yazandweiri9380/wireless-nerve-stimulator/README.md

# wireless-nerve-stimulator
Hardware designs, firmware, and supporting software for a compact wireless peripheral nerve stimulator with onboard inverse mapping.
