yazandweiri9380/wireless-nerve-stimulator/Electronics/PCB Design Files/SlikScreen.pdf

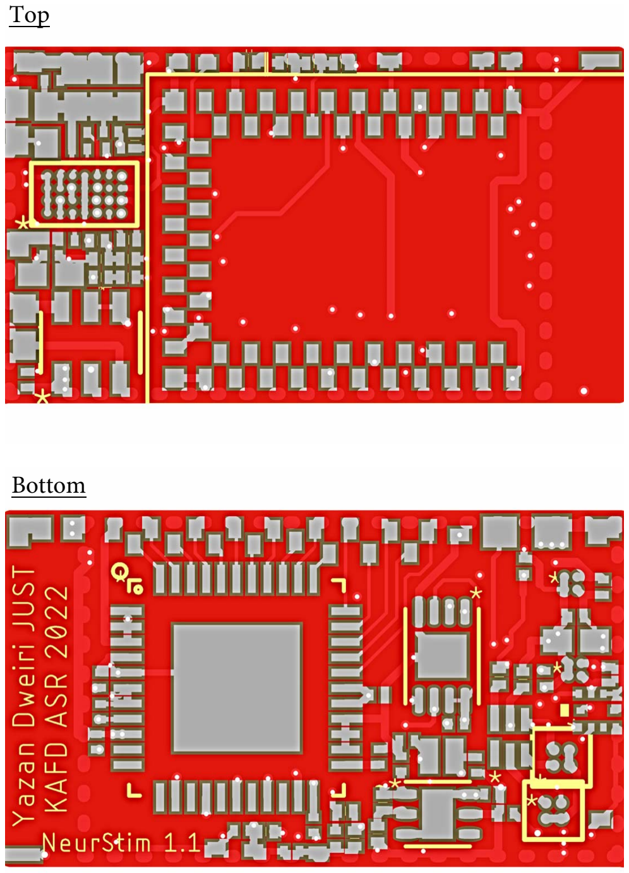
[picture p1: page 1]

Top

Bottom

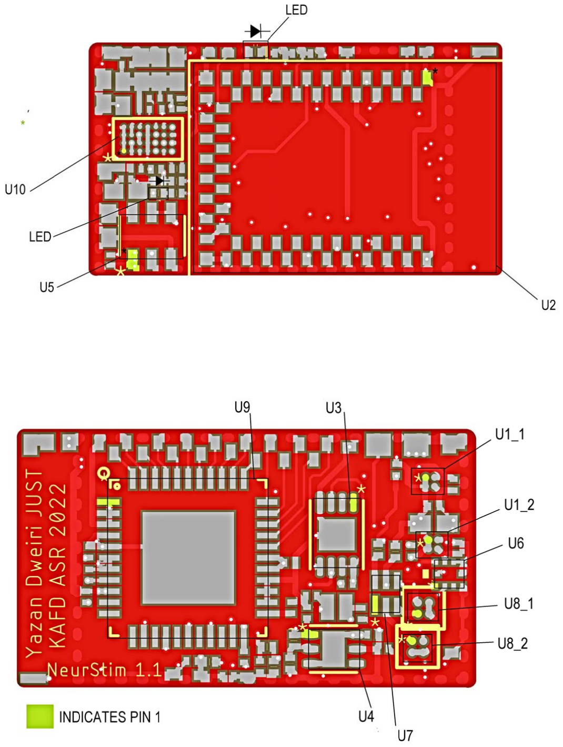
[picture p2: page 2]
