yazandweiri9380/wireless-nerve-stimulator/Electronics/PCB Design Files/Bottom2.png

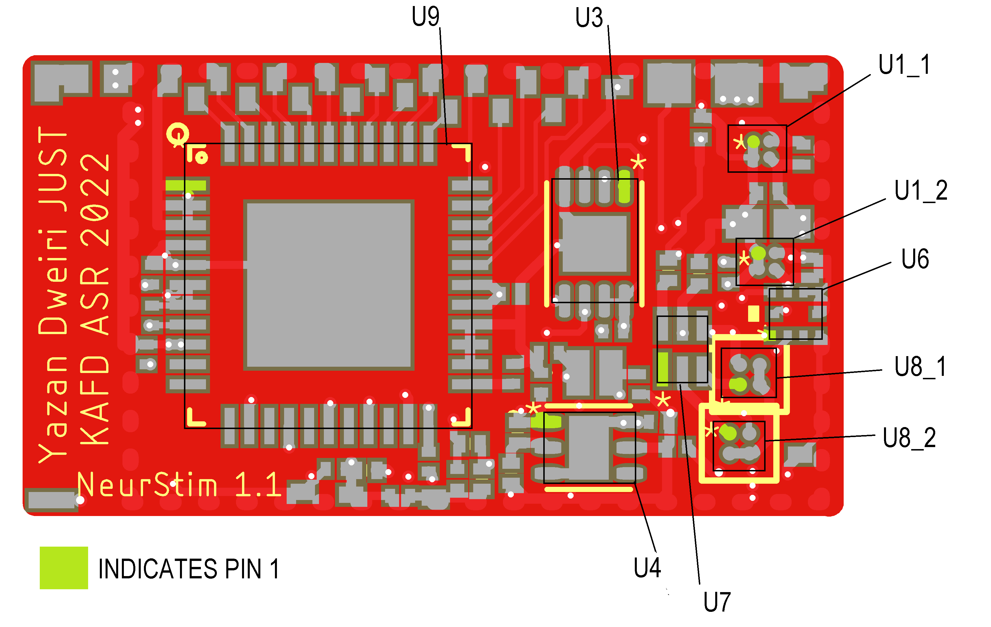
Electronics/PCB Design Files/Bottom2.png
