yazandweiri9380/wireless-nerve-stimulator/Electronics/PCB Design Files/Bottom.png

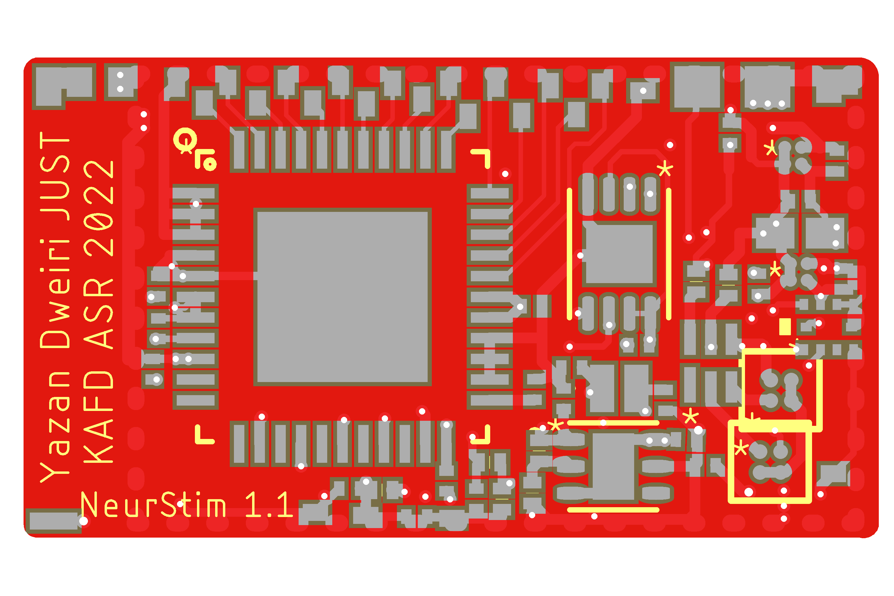
Electronics/PCB Design Files/Bottom.png
