yazandweiri9380/wireless-nerve-stimulator/Electronics/PCB Design Files/Top2.png

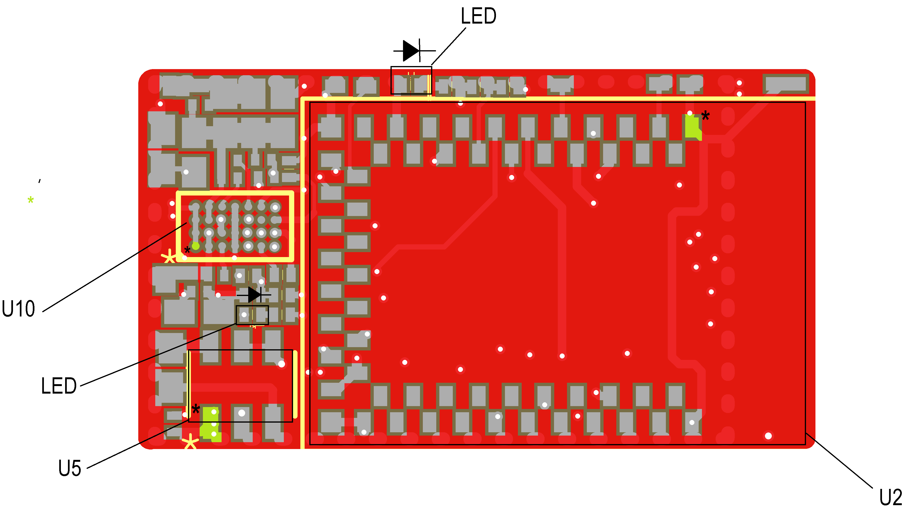
Electronics/PCB Design Files/Top2.png
