yazandweiri9380/wireless-nerve-stimulator/Electronics/PCB Design Files/Top.png

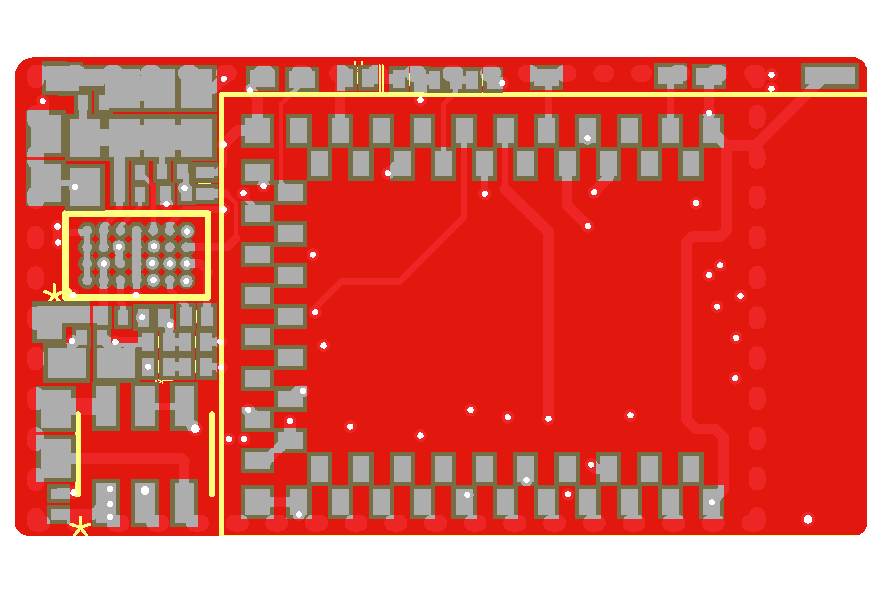
Electronics/PCB Design Files/Top.png
