yazandweiri9380/wireless-nerve-stimulator/Electronics/PCB Design Files/BOM.xlsx

Sheet: 华秋商城BOM报价明细
“客户”的BOM需求数据
单机用量 | 位号 | 规格参数 | 型号 | 封装 | 备注 | Model | Description | Brand | Package | Quantity for 60pcs | Price for 60 pcs | Delivery days(working days)
2 | C1_1, C1_2 | 0.068uF |  | C0402K | 445-7346-1-ND | CC0402KRX7R9BB683 | 贴片电容（MLCC） 68nF ±10% 50V X7R 0402 | Yageo | 0402 | 60 | $0.23 | 1-3days
2 | C2_1,C2_2 | 15pF |  | C0200 | 490-GJM0335C1H150GB01DCT-ND | 0201CG150J500NT | 贴片电容（MLCC） 15pF ±5% 50V C0G(NP0) 0201 | FH | 0201 | 60 | $0.03 | 1-3days | Package is 0201
3 | C3_1, C3_2, C3_3 | 10nF |  | C0201 | 587-5943-1-ND | 0201B103K500NT | 贴片电容（MLCC） 10nF ±10% 50V X7R 0201 | FH | 0201 | 65 | $0.03 | 1-3days
6 | C4_1, C4_2, C4_3, C4_4, C4_5, C4_6 | 100nF |  | C0201 | 490-GRM033Z71C104ME14DCT-ND | 0201X104K160NT | 贴片电容（MLCC） 100nF ±10% 16V X5R 0201 | FH | 0201 | 80 | $0.18 | 1-3days
3 | C5_1, C5_2, C5_3 | 2.2uF |  | C0201 | 490-13227-1-ND | 0201X225M6R3NT | 贴片电容（MLCC） 2.2μF ±20% 6.3V X5R 0201 | FH | 0201 | 65 | $0.31 | 1-3days
8 | C6_1, C6_2, C6_3, C6_4, C6_5, C6_6, C6_7, C6_8 | 1uF |  | C0201 | 1276-6798-1-ND | 0201X105M6R3NT | 贴片电容（MLCC） 1μF ±20% 6.3V X5R 0201 | FH | 0201 | 90 | $0.14 | 1-3days
2 | C7_1, C7_2 | 4.7uF |  | C0402K | 1276-6836-1-ND | 0402X475M100NT | 贴片电容（MLCC） 4.7μF ±20% 10V X5R 0402 | FH | 0402 | 60 | $0.70 | 1-3days
3 | C8_1, C8_2, C8_3 | 0.022uF |  | C0201 | 587-EMK063B7223KP-FCT-ND | 0201X223K100NT | 贴片电容（MLCC） 22nF ±10% 10V X5R 0201 | FH | 0201 | 65 | $0.08 | 1-3days
2 | C9_1, C9_2 | 0.47uF |  | C0402K | 587-3497-1-ND | 0402X474K500CT | 贴片电容（MLCC） 470nF ±10% 50V X5R 0402 | Walsin | 0402 | 60 | $0.55 | 1-3days
1 | C10 | 1uF |  | C0402K |  | C0402X5R105K500NT | 贴片电容（MLCC） 1μF ±10% 50V X5R 0402 | Sanyear | 0402 | 55 | $0.54 | 1-3days
1 | C11 | 100pF |  | C0201 | 445-12105-1-ND | CSA0201C0G101J500ET | 贴片电容（MLCC） 100pF ±5% 50V C0G 0201 | HRE | 0201 | 55 | $0.03 | 1-3days
1 | C12 | 10nF | C0603C103J3GACTU | C0603 |  | C0603C103J3GACTU | 贴片电容（MLCC） 10nF ±5% 25V C0G (NP0) 0603 | KEMET | 0603 | 55 | $13.72 | 8-15days
1 | C13 | 0.047uF |  | C0201 | 445-13679-1-ND | 0201X473K100NT | 贴片电容（MLCC） 47nF ±10% 10V X5R 0201 | FH | 0201 | 55 | $0.08 | 1-3days
1 | C14 | 1800pF |  | C0402K | 399-C0402C182J5RAC7867CT-ND | TCC0402X7R182K500AT | 贴片电容（MLCC） 1.8nF ±10% 50V X7R 0402 | CCTC | 0402 | 55 | $0.04 | 1-3days
1 | C15 | 1nF |  | C0201 |  | TCC0201X7R102K500ZT | 贴片电容（MLCC） 1nF ±10% 50V X7R 0201 | CCTC | 0201 | 55 | $0.03 | 1-3days
1 | R1 | 187k |  | R0201 | 13-RE0201BRE07191KPDKR-ND | 0201WMF1873TCE | 贴片电阻 187KΩ ±1% 1/20W ±200ppm/℃ 0201 | UniOhm | 0201 | 55 | $0.07 | 1-3days
5 | R2_1, R2_2, R2_3, R2_4, R2_5 | 100k |  | R0201 | P15981CT-ND | RC-01W1003FT | 贴片电阻 100KΩ ±1% 1/20W ±200ppm/℃ 0201 | FH | 0201 | 75 | $0.04 | 1-3days
1 | R3 | 5.1k |  | R0201 | P123051CT-ND | RC-01W512JT | 贴片电阻 5.1KΩ ±5% 50mW ±200ppm/℃ 0201 | FH | 0201 | 55 | $0.03 | 1-3days
1 | R4 | 2.43k |  | R0201 | P122861CT-ND | WR02X2431FAL | 贴片电阻 2.43KΩ ±1% 1/20W ±200ppm/℃ 0201 | Walsin | 0201 | 55 | $0.05 | 1-3days
1 | R5 | 196R |  | R0201 | P122806CT-ND | RC0201FR-07196RL | 贴片电阻 196Ω ±1% 1/20W ±200ppm/℃ 0201 | Yageo | 0201 | 55 | $0.03 | 1-3days
2 | R6_1, R6_2 | 100R |  | R0201 | 311-100MCT-ND | RC0201JR-07100RL | 贴片电阻 100Ω ±5% 1/20W ±200ppm/℃ 0201 | Yageo | 0201 | 60 | $0.03 | 1-3days
1 | R7 | 330R |  | R0201 |  | RC-01W331JT | 贴片电阻 330Ω ±5% 50mW ±200ppm/℃ 0201 | FH | 0201 | 55 | $0.03 | 1-3days
1 | R8 | 2.2k |  | R0201 |  | CR0201JH0222G | 贴片电阻 2.2KΩ ±5% 1/20W ±200ppm/℃ 0201 | LIZ | 0201 | 55 | $0.03 | 1-3days
1 | R9 | 220k |  | R0201 |  | 0201WMJ0224TEE | 贴片电阻 220KΩ ±5% 1/20W ±200ppm/℃ 0201 | Uniohm | 0201 | 55 | $0.02 | 1-3days
1 | R10 | 150k |  | R0201 | P122745CT-ND | RC-01W1503FT | 贴片电阻 150KΩ ±1% 50mW ±200ppm/℃ 0201 | FH | 0201 | 55 | $0.03 | 1-3days
1 | R11 | 10k |  | R0201 | P15980CT-ND | RC-01W103JT | 贴片电阻 10KΩ ±5% 50mW ±200ppm/℃ 0201 | FH | 0201 | 55 | $0.02 | 1-3days
1 | FUSE | F0402G0R06FNTR | F0402G0R06FNTR | R0402 |  | F0402G0R06FNTR | FUSE BOARD MOUNT 62MA 32VDC 0402 | AVX | 0402 | 55 | $48.90 | 8-15days
1 | LED | APG0603SEC-TT | APG0603SEC-TT | R0201 |  | APG0603SEC-TT | Orange 605nm LED Indication - Discrete 2.01V 2-SMD, No Lead | KINGBRIGHT | 2-SMD，0201 | 55 | $25.44 | 8-15days
1 | LED_MC_INDICATOR | APG0603SEC-E-TT | APG0603SEC-E-TT | R0201 |  | APG0603SEC-E-TT | Red 624nm LED Indication - Discrete 1.93V 2-SMD, No Lead | KINGBRIGHT | 2-SMD，0201 | 55 | $25.44 | 8-15days
2 | U1_1, U1_2 | ADP150ACBZ-3.3-R7 | ADP150ACBZ-3.3-R7 | WLCSP-4 | ADP150ACBZ-3.3-R7CT-ND | ADP150ACBZ-3.3-R7 |  | ADI/AD | - | 11 | $8.99 | 3-5days
1 | U2 | SUB-14402 |  | ARTEMIS_FP | 提供完整型号或参考链接 |  |  |  |  |  | $0.00 |  | PLease offer completed model or link
1 | U3 | MB85RC64TAPN-G-AMEWE1 | MB85RC64TAPN-G-AMEWE1 | SON-8 |  | MB85RC64TAPN-G-AMEWE1 | SON8_2X3MM_EP 64 (8K x 8)KB 3.4MHz | FUJITSU | SON8_2X3MM_EP | 6 | $8.63 | 1-3days
1 | U4 | ADP7182ACPZN-R7 | ADP7182ACPZN-R7 | LFCSP-6 | 505-ADP7182ACPZN-R7TR-ND | ADP7182ACPZN-R7 |  | ADI/AD | - | 5 | $12.25 | 3-5days
1 | U5 | ADM8829ARTZ-REELRJ | ADM8829ARTZ-REELRJ | SOT-23-6 | ADM8829ARTZ-REELCT-ND |  |  |  |  |  | $0.00 |  | Out of stock, please offer us the link
1 | U6 | TPS22946YZPR | TPS22946YZPR | BGA | 296-25219-1-ND | TPS22946YZPR | IC PWR SWITCH P-CHAN 1:1 6DSBGA | TI | XFBGA6 | 5 | $8.86 | 1-3days
1 | U7 | BQ29733DSET | BQ29733DSET | WSON-6(1.5x1.5) | BQ29733DSET-ND | BQ29733DSET | IC BATT PROT LI-ION 1CELL 6WSON | TI | WFDFN6 | 5 | $8.93 | 10-15days
2 | U8_1, U8_2 | CSD13201W10 | CSD13201W10 | DSBGA-4 | 296-41412-1-ND | CSD13201W10 |  | TEXAS INSTRUMENTS | - | 12 | $2.35 | 3-5days
1 | U9 | RHS2116_QFN | RHS2116_QFN | QFN44_7_X_7 |  |  |  |  |  |  | $0.00 |  | Out of stock, please offer us the link
1 | U10 | BQ51051BYFPT | BQ51051BYFPT | DSBGA-28 | 2156-BQ51051BYFPT-ND | BQ51051BYFPT | IC WIRELESS PWR RCVR 28DSBGA | TI | 28-XFBGA，DSBGA | 5 | $35.66 | 8-10days
1 | Y1 | ECS-.327-12.5-1210-TR | ECS-.327-12.5-1210-TR | 1210 | XC2282DKR-ND | ECS-.327-12.5-1210-TR | 无源晶振 | ECS | SMD1210-2P | 6 | $12.26 | 15-20days
 |  |  |  |  |  |  |  |  |  | in total= | $214.82

Sheet: Sheet1
Id | Designator | Footprint | Quantity | Designation | Supplier and ref | Model | Brand | Package | Quantity for 60pcs | Price for 60 pcs
2 | C1_1, C1_2 | C0402K_334 | 2 | 0.068uF |  | CC0402KRX7R9BB683 | Yageo | 402 | 60 | $0.23
3 | C2_1, C2_2 | C0201_334 | 2 | 15pF |  | 0201CG150J500NT | FH | 201 | 60 | $0.03
4 | C3_1, C3_2, C3_3 | C0201_334 | 3 | 10nF |  | 0201B103K500NT | FH | 201 | 65 | $0.03
5 | C4_1, C4_2, C4_3, C4_4, C4_5, C4_6 | C0201_334 | 6 | 100nF |  | 0201X104K160NT | FH | 201 | 80 | $0.18
6 | C5_1, C5_2, C5_3 | C0201_334 | 3 | 2.2uF |  | 0201X225M6R3NT | FH | 201 | 65 | $0.31
7 | C6_1, C6_2, C6_3, C6_4, C6_5, C6_6, C6_7, C6_8 | C0201_334 | 8 | 1uF |  | 0201X105M6R3NT | FH | 201 | 90 | $0.14
8 | C7_1, C7_2 | C0402K_334 | 2 | 4.7uF |  | 0402X475M100NT | FH | 402 | 60 | $0.70
9 | C8_1, C8_2, C8_3 | C0201_334 | 3 | 0.022uF |  | 0201X223K100NT | FH | 201 | 65 | $0.08
10 | C9_1, C9_2 | C0402K_334 | 2 | 0.47uF |  | 0402X474K500CT | Walsin | 402 | 60 | $0.55
11 | C10 | C0402K_334 | 1 | 1uF |  | C0402X5R105K500NT | Sanyear | 402 | 55 | $0.54
12 | C11 | C0201_334 | 1 | 100pF |  | CSA0201C0G101J500ET | HRE | 201 | 55 | $0.03
13 | C12 | C0603_334 | 1 | 10nF |  | C0603C103J3GACTU | KEMET | 603 | 55 | $13.72 | 1
14 | C13 | C0201_334 | 1 | 0.047uF |  | 0201X473K100NT | FH | 201 | 55 | $0.08
15 | C14 | C0402K_334 | 1 | 1800pF |  | TCC0402X7R182K500AT | CCTC | 402 | 55 | $0.04
16 | C15 | C0201_334 | 1 | 1nF |  | TCC0201X7R102K500ZT | CCTC | 201 | 55 | $0.03
17 | FUSE0 | R0402_334 | 1 | 62.5mA |  | F0402G0R06FNTR | AVX | 402 | 55 | $48.90 | 1
18 | LED0, LED_MC_INDICATOR0 | R0201_334 | 2 | LED
19 | R1 | R0201_334 | 1 | 187k |  | 0201WMF1873TCE | UniOhm | 201 | 55 | $0.07
20 | R2_1, R2_2, R2_3, R2_4, R2_5 | R0201_334 | 5 | 100k |  | RC-01W1003FT | FH | 201 | 75 | $0.04
21 | R3 | R0201_334 | 1 | 5.1k |  | RC-01W512JT | FH | 201 | 55 | $0.03
22 | R4 | R0201_334 | 1 | 2.43k |  | WR02X2431FAL | Walsin | 201 | 55 | $0.05
23 | R5 | R0201_334 | 1 | 196 |  | RC0201FR-07196RL | Yageo | 201 | 55 | $0.03
24 | R6_1, R6_2 | R0201_334 | 2 | 100 |  | RC0201JR-07100RL | Yageo | 201 | 60 | $0.03
25 | R7 | R0201_334 | 1 | 330 |  | RC-01W331JT | FH | 201 | 55 | $0.03
26 | R8 | R0201_334 | 1 | 2.2k |  | CR0201JH0222G | LIZ | 201 | 55 | $0.03
27 | R9 | R0201_334 | 1 | 220k |  | 0201WMJ0224TEE | Uniohm | 201 | 55 | $0.02
28 | R10 | R0201_334 | 1 | 150k |  | RC-01W1503FT | FH | 201 | 55 | $0.03
29 | R11 | R0201_334 | 1 | 10k |  | RC-01W103JT | FH | 201 | 55 | $0.02
30 | U1_1, U1_2 | CB_4_3_ADI | 2 | ADP150ACBZ-3.3-R7 | ADP150ACBZ-3.3-R7CT-ND | ADP150ACBZ-3.3-R7 | ADI/AD | - | 11 | $8.99 | 1 | 1.28 | 2.56
31 | U2 | ARTEMIS_FP | 1 | ARTEMIS_MODULESMD | 1568-15484-ND |  |  |  |  | $10.31 | 10 | 10.31 | 10.31
32 | U3 | 8-UQFN | 1 | CY15B104QN-20LPXC |  | CY15B104QN-20LPXC | Infineon Technologies | 8-UQFN |  | $21.59 | 2
33 | U4 | SON65P200X200X65-7N | 1 | ADP7182ACPZN-R7 | 505-ADP7182ACPZN-R7TR-ND | ADP7182ACPZN-R7 | ADI/AD | - | 5 | $12.25 | 3
34 | U5 | RJ_6_ADI-L | 1 | ADM8829ARTZ-REELRJ_6_ADI-L | ADM8829ARTZ-REELCT-ND |  |  |  |  | $4.00 | 4 | 3.99 | 3.99
35 | U6 | MC3635_MEM-L | 1 | MC3635MC3635_MEM-L | 296-25219-1-ND | TPS22946YZPR | TI | XFBGA6 | 5 | $8.86 | 2 | 1.22 | 1.22
36 | U7 | DSE6_TEX | 1 | BQ29733DSET | BQ29733DSET-ND | BQ29733DSET | TI | WFDFN6 | 5 | $8.93 | 2 | 1.19 | 1.19
37 | U8_1, U8_2 | YZB4_TEX | 2 | CSD13201W10 | 296-41412-1-ND | CSD13201W10 | TEXAS INSTRUMENTS | - | 12 | $2.35 | 1 | 0.6 | 1.2
38 | U9 | QFN44_7_X_7 | 1 | RHS2116_QFN |  |  |  |  |  | $392.00 |  | 392 | 392
39 | U10 | YFP28 | 1 | BQ51051BYFPT | 2156-BQ51051BYFPT-ND | BQ51051BYFPT | TI | 28-XFBGA, DSBGA | 5 | $35.66 | 8 | 5.54 | 5.54
40 | Y1 | XTAL_ECS-.327-12.5-1210-TR | 1 | ECS-.327-12.5-1210-TR | XC2282DKR-ND | ECS-.327-12.5-1210-TR | ECS | SMD1210-2P | 6 | $12.26 | 2 | 1.39 | 1.39
 |  |  | 1 |  | Coil | WR222230-26M8-G |  |  |  | $3.47 |  | 3.47 | 3.47
 |  |  | 1 |  | Battery | CG-420A/M3 |  |  |  | $18.4 |  | 18.4 | 18.4
 |  |  | 2 |  | Reed SW | 2010-1264-1-ND |  |  |  | $1.44 |  | 1.44 | 2.88
 |  |  |  |  |  |  |  |  |  | $0.00
