yazandweiri9380/wireless-nerve-stimulator/Electronics/PCB Design Files/Implantable_Order5il_V2_Dec9_2022.brd

## EAGLE design Electronics/PCB Design Files/Implantable_Order5il_V2_Dec9_2022.brd (2026-10-24)

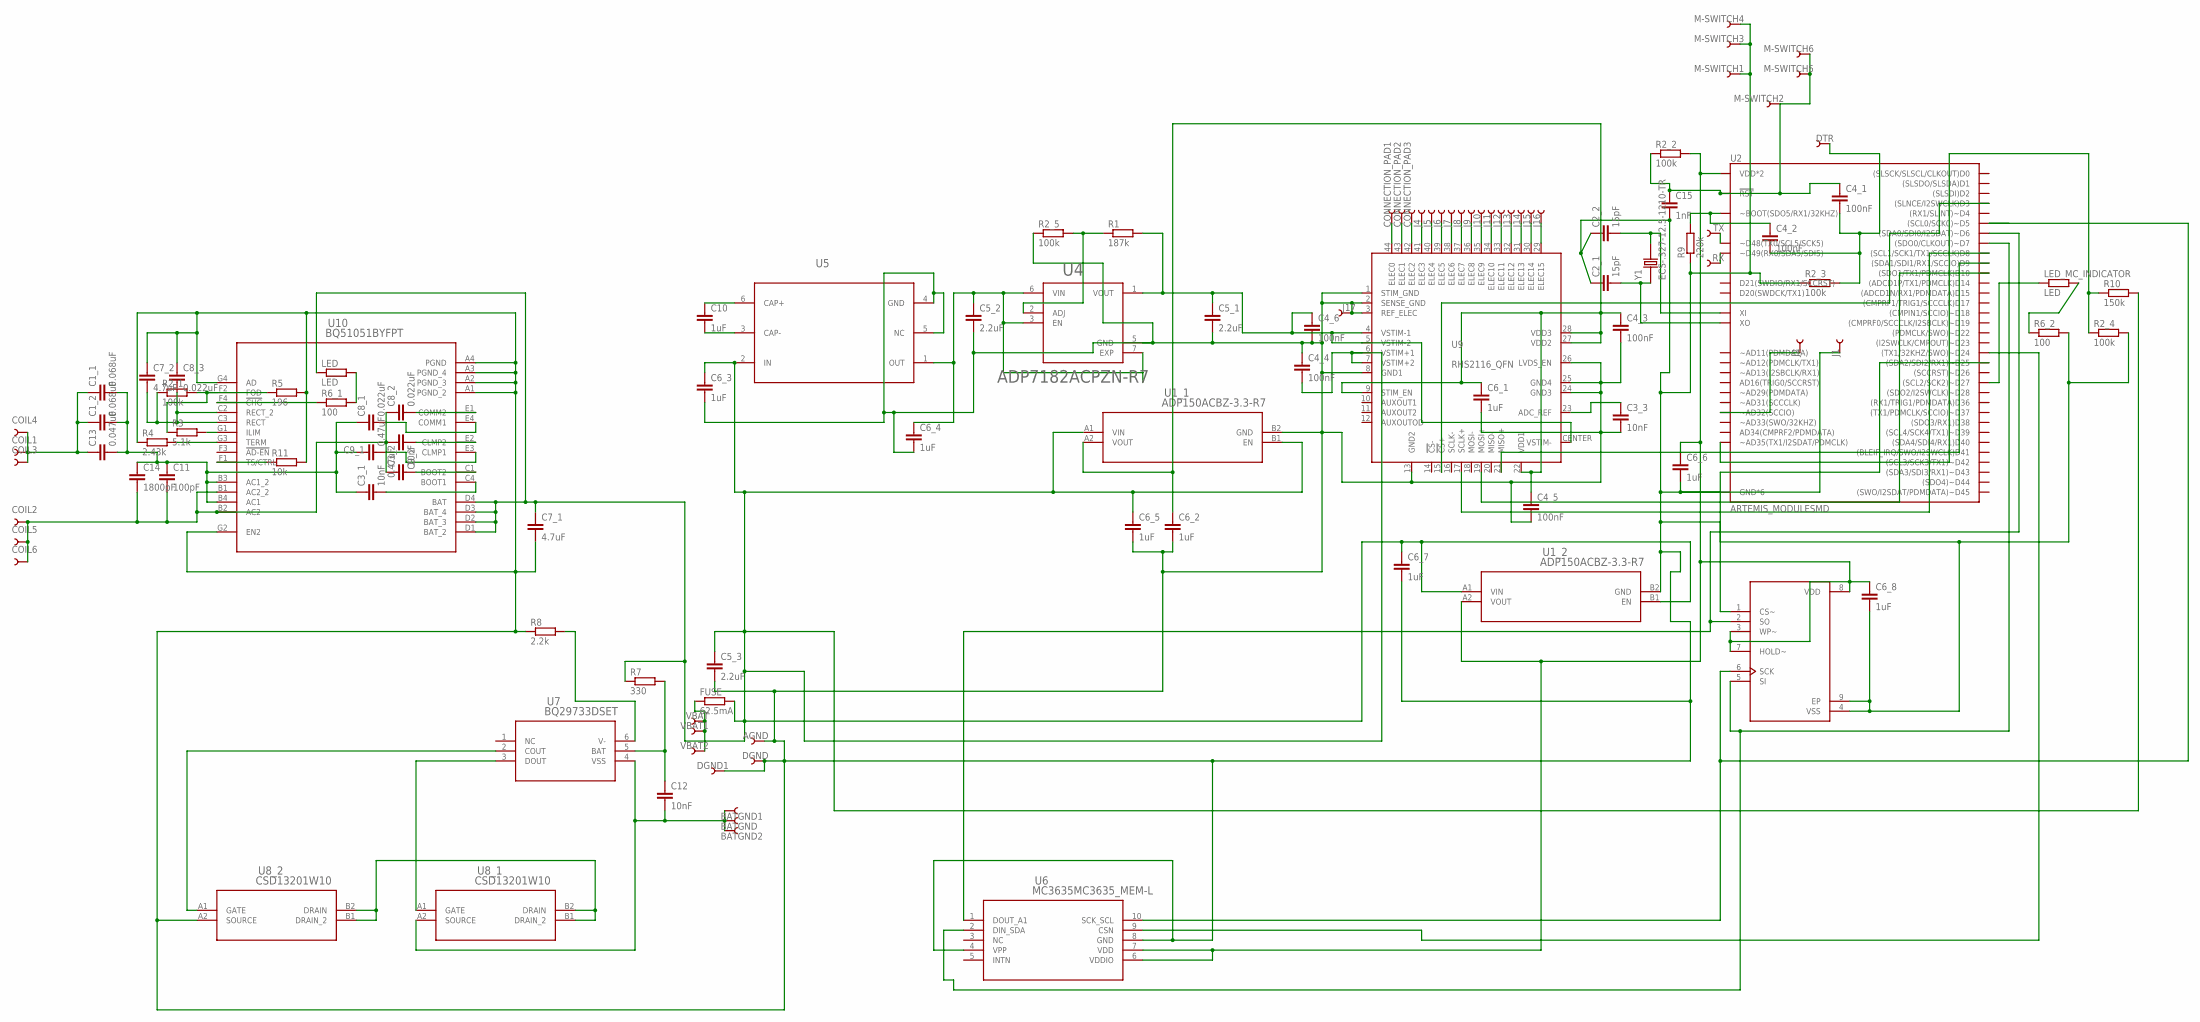
[picture p7: schematic Implantable_Order5il_V2_Dec9_2022.sch]

Parts:
AGND: PAD.4X.6; MODULE_PAD
BATGND, BATGND1, BATGND2: PAD.4X.6; MODULE_PAD
C1_1, C1_2: 0.068uF; C0402K; DIGIKEY 445-7346-1-ND
C2_1, C2_2: 15pF; C0201
C3_1, C3_2, C3_3: 10nF; C0201; DIGIKEY 587-5943-1-ND
C4_1, C4_2, C4_3, C4_4, C4_5, C4_6: 100nF; C0201
C5_1, C5_2, C5_3: 2.2uF; C0201; DIGIKEY 490-13227-1-ND
C6_1, C6_2, C6_3, C6_4, C6_5, C6_6, C6_7, C6_8: 1uF; C0201
C7_1, C7_2: 4.7uF; C0402K; DIGIKEY 1276-6836-1-ND
C8_1, C8_2, C8_3: 0.022uF; C0201; DIGIKEY 587-EMK063B7223KP-FCT-ND
C9_1, C9_2: 0.47uF; C0402K; DIGIKEY 587-3497-1-ND
C10: 1uF; C0402K
C11: 100pF; C0201; DIGIKEY 445-12105-1-ND
C12: 10nF; C0603; DIGIKEY C0603C103J3GACTU
C13: 0.047uF; C0201; DIGIKEY 445-13679-1-ND
C14: 1800pF; C0402K; DIGIKEY 399-C0402C182J5RAC7867CT-ND
C15: 1nF; C0201
COIL1, COIL2, COIL3, COIL4, COIL5, COIL6: PAD.4X.6; MODULE_PAD
CONNECTION_PAD1, CONNECTION_PAD2, CONNECTION_PAD3: PAD.4X.6; MODULE_PAD
DGND, DGND1: PAD.4X.6; MODULE_PAD
DTR: PAD.4X.6; MODULE_PAD
FUSE: 62.5mA; R0402; DIGIKEY F0402G0R06FNTR
J1, J2, J4, J5, J6, J7, J8, J9, J10, J11, J12, J13, J14, J15, J16, J17: PAD.4X.6; MODULE_PAD
LED: LED; R0201; DIGIKEY APG0603SEC-TT
LED_MC_INDICATOR: LED; R0201; DIGIKEY APG0603SEC-E-TT
M-SWITCH1, M-SWITCH2, M-SWITCH3, M-SWITCH4, M-SWITCH5, M-SWITCH6: PAD.4X.6; MODULE_PAD
R1: 187k; R0201; DIGIKEY 541-CRCW0201174KFNEDCT-ND
R2_1, R2_2, R2_3, R2_4: 100k; R0201
R2_5: 100k; R0201; DIGIKEY 541-2941-1-ND
R3: 5.1k; R0201
R4: 2.43k; R0201
R5: 196; R0201
R6_1, R6_2: 100; R0201
R7: 330; R0201
R8: 2.2k; R0201
R9: 220k; R0201
R10: 150k; R0201
R11: 10k; R0201
RX: PAD.4X.6; MODULE_PAD
TX: PAD.4X.6; MODULE_PAD
U1_1, U1_2: ADP150ACBZ-3.3-R7; CB_4_3_ADI
U2: ARTEMIS_MODULESMD; ARTEMIS_FP
U3: MB85RC64TAPN-G-AMEWE1; SON50P200X300X75-9N
U4: ADP7182ACPZN-R7; SON65P200X200X65-7N
U5: ADM8829ARTZ-REELRJ_6_ADI-L; RJ_6_ADI-L
U6: MC3635MC3635_MEM-L; MC3635_MEM-L
U7: BQ29733DSET; DSE6_TEX
U8_1, U8_2: CSD13201W10; YZB4_TEX
U9: RHS2116_QFN; QFN44_7_X_7
U10: BQ51051BYFPT; YFP28
VBAT, VBAT1, VBAT2: PAD.4X.6; MODULE_PAD
Y1: ECS-.327-12.5-1210-TR; XTAL_ECS-.327-12.5-1210-TR

Connections:
BG: BATGND.1, BATGND1.1, BATGND2.1, C12.2, U7.4 (VSS), U8_1.A2 (SOURCE)
BOOT: C4_2.1, R9.2, U2.BOOT (~BOOT(SDO5/RX1/32KHZ))
CS2: U2.~D25 ((SDA2/SDI2/RX1)~D25), U3.1 (CS~)
DRT: C4_1.2, C4_2.2, DTR.1, R2_3.2
G: AGND.1, C2_1.1, C2_2.1, C3_3.2, C4_3.2, C4_4.1, C4_5.2, C4_6.2, C5_1.2, C5_2.2, C5_3.2, C6_1.2, C6_2.2, C6_3.2, C6_4.2, C6_5.2, C6_6.2, C6_7.2, C6_8.2, C7_1.2, C7_2.1, C8_3.1, C15.2, DGND.1, DGND1.1, J1.1, J17.1, M-SWITCH1.1, M-SWITCH3.1, M-SWITCH4.1, R2_3.1, R2_4.2, R2_5.1, R4.1, R5.2, R6_2.2, R8.1, R9.1, R11.2, U1_1.B2 (GND), U1_2.B2 (GND), U2.GND@1 (GND*6), U2.GND@22 (GND*6), U2.GND@38 (GND*6), U2.GND@39 (GND*6), U2.GND@47 (GND*6), U2.GND@59 (GND*6), U3.4 (VSS), U3.9 (EP), U4.5 (GND), U5.4 (GND), U5.5 (NC), U6.4 (VPP), U6.8 (GND), U8_2.A2 (SOURCE), U9.1 (STIM_GND), U9.2 (SENSE_GND), U9.3 (REF_ELEC), U9.8 (GND1), U9.13 (GND2), U9.24 (GND3), U9.25 (GND4), U9.26 (LVDS_EN), U10.A1 (PGND_2), U10.A2 (PGND_3), U10.A3 (PGND_4), U10.A4 (PGND), U10.G2 (EN2), U10.G4 (AD)
MISO: U2.D9 ((SDA1/SDI1/RX1/SCCIO)D9), U9.21 (MISO+)
MOSI: U2.D10 ((SDO1/TX1/PDMCLK)D10), U9.19 (MOSI+)
MS+: C4_1.1, C15.1, M-SWITCH2.1, M-SWITCH5.1, M-SWITCH6.1, R2_2.1, U2.~RST (!RST)
unnamed: J6.1, U9.39 (ELEC5)
unnamed: J16.1, U9.29 (ELEC15)
unnamed: CONNECTION_PAD1.1, U9.44 (ELEC0)
unnamed: CONNECTION_PAD2.1, U9.43 (ELEC1)
unnamed: CONNECTION_PAD3.1, U9.42 (ELEC2)
unnamed: J4.1, U9.41 (ELEC3)
unnamed: J5.1, U9.40 (ELEC4)
unnamed: J7.1, U9.38 (ELEC6)
unnamed: J8.1, U9.37 (ELEC7)
unnamed: J9.1, U9.36 (ELEC8)
unnamed: J10.1, U9.35 (ELEC9)
unnamed: J11.1, U9.34 (ELEC10)
unnamed: J12.1, U9.33 (ELEC11)
unnamed: J13.1, U9.32 (ELEC12)
unnamed: J14.1, U9.31 (ELEC13)
unnamed: J15.1, U9.30 (ELEC14)
unnamed: R2_4.1, R10.1, U2.~AD35 (~AD35(TX1/I2SDAT/PDMCLK))
unnamed: C2_1.2, U2.XO, Y1.1 (IN/OUT)
unnamed: C12.1, R7.2, U7.5 (BAT)
unnamed: LED_MC_INDICATOR.1, U2.~D27 ((SCL2/SCK2)~D27)
unnamed: FUSE.1, VBAT.1, VBAT1.1, VBAT2.1
unnamed: C4_6.1, C5_1.1, R1.2, U4.1 (VOUT), U9.4 (VSTIM-1), U9.5 (VSTIM-2), U9.CENTER (VSTIM-)
unnamed: U2.D3 ((SLNCE/I2SWCLK)D3), U9.15 (!CS!+)
unnamed: C2_2.2, U2.XI, Y1.2 (OUT/IN)
unnamed: U7.3 (DOUT), U8_1.A1 (GATE)
unnamed: J2.1, U2.~AD32 (~AD32(SCCIO))
unnamed: C5_2.1, C6_4.1, U4.3 (EN), U4.6 (VIN), U4.7 (EXP), U5.1 (OUT)
unnamed: C3_3.1, U9.23 (ADC_REF)
unnamed: R1.1, R2_5.2, U4.2 (ADJ)
unnamed: U7.2 (COUT), U8_2.A1 (GATE)
unnamed: TX.1, U2.TXO-0 (~D48(TX0/SCL5/SCK5))
unnamed: C10.1, U5.6 (CAP+)
unnamed: C10.2, U5.3 (CAP-)
unnamed: C1_1.1, C1_2.1, C13.1, COIL1.1, COIL3.1, COIL4.1
unnamed: C8_2.2, U10.E1 (COMM2)
unnamed: U8_1.B1 (DRAIN_2), U8_1.B2 (DRAIN), U8_2.B1 (DRAIN_2), U8_2.B2 (DRAIN)
unnamed: R8.2, U7.6 (V-)
unnamed: C7_2.2, C8_3.2, R2_1.1, U10.C2 (RECT_2), U10.C3 (RECT)
unnamed: C3_1.2, U10.C4 (BOOT1)
unnamed: C9_1.2, U10.E3 (CLMP1)
unnamed: C8_1.2, U10.E4 (COMM1)
unnamed: R2_1.2, R3.1, R5.1, U10.F2 (FOD)
unnamed: C1_1.2, C1_2.2, C3_1.1, C8_1.1, C9_1.1, C11.1, C13.2, C14.1, U10.B3 (AC1_2), U10.B4 (AC1)
unnamed: C9_2.1, U10.E2 (CLMP2)
unnamed: C3_2.2, U10.C1 (BOOT2)
unnamed: C3_2.1, C8_2.1, C9_2.2, C11.2, C14.2, COIL2.1, COIL5.1, COIL6.1, U10.B1 (AC2_2), U10.B2 (AC2)
unnamed: R11.1, U10.F1 (TS/CTRL)
unnamed: R3.2, U10.G1 (ILIM)
unnamed: R4.2, U10.G3 (TERM)
unnamed: R6_1.1, U10.F4 (!CHG)
unnamed: LED.2, R6_1.2
unnamed: U2.~D24 ((TX1/32KHZ/SWO)~D24), U6.9 (CSN)
unnamed: RX.1, U2.RXI-0 (~D49(RX0/SDA5/SDI5))
unnamed: LED_MC_INDICATOR.2, R6_2.1
SCK: U2.D8 ((SCL1/SCK1/TX1/SCCLK)D8), U9.17 (SCLK+)
SCK2: U2.~D5 ((SCL0/SCK0)~D5), U3.6 (SCK), U6.10 (SCK_SCL)
SI: U2.D7 ((SDO0/CLKOUT)~D7), U3.5 (SI), U6.2 (DIN_SDA)
SO: U2.~D6 ((SDA0/SDI0/I2SDAT)~D6), U3.2 (SO), U6.1 (DOUT_A1)
VBAT: C4_4.2, C5_3.1, C6_3.1, C6_5.1, C6_7.1, C7_1.1, FUSE.2, LED.1, R7.1, R10.2, U1_1.A1 (VIN), U1_1.B1 (EN), U1_2.A1 (VIN), U1_2.B1 (EN), U5.2 (IN), U9.6 (VSTIM+1), U9.7 (VSTIM+2), U10.D1 (BAT_2), U10.D2 (BAT_3), U10.D3 (BAT_4), U10.D4 (BAT)
V_INTAN: C4_3.1, C4_5.1, C6_1.1, C6_2.1, U1_1.A2 (VOUT), U9.9 (STIM_EN), U9.22 (VDD1), U9.27 (VDD2), U9.28 (VDD3)
V_MC: C6_6.1, C6_8.1, R2_2.2, U1_2.A2 (VOUT), U2.VDD@36 (VDD*2), U2.VDD@37 (VDD*2), U3.3 (WP~), U3.7 (HOLD~), U3.8 (VDD), U6.6 (VDDIO), U6.7 (VDD)

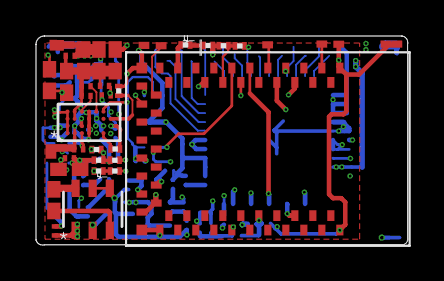
[picture p8: board Implantable_Order5il_V2_Dec9_2022.brd from above]

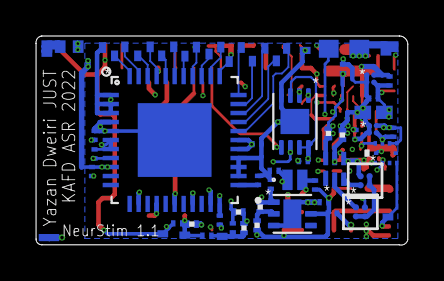
[picture p9: board Implantable_Order5il_V2_Dec9_2022.brd from below]

Board: 4 copper layers, 20.7 x 11.6 mm, 112 parts (70 on the bottom side), 69 nets.
